aamna-builds/mearm-robotic-arm/media/photos/tinkercad-3d-top.png

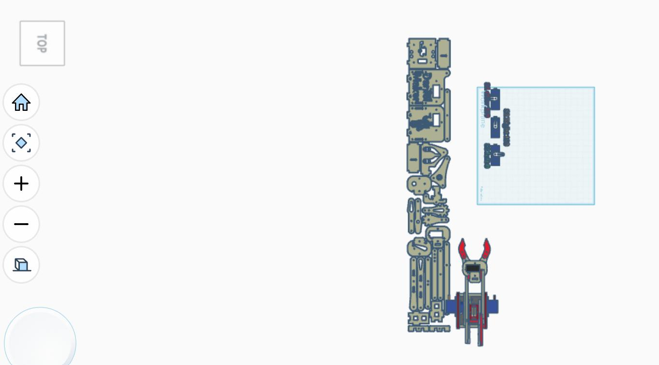
media/photos/tinkercad-3d-top.png
